csihyeon05/D4D-x-EDTH-Hackathon---Team.-Squad-HUD/pcb/Screenshot From 2026-10-11 06-26-00.png

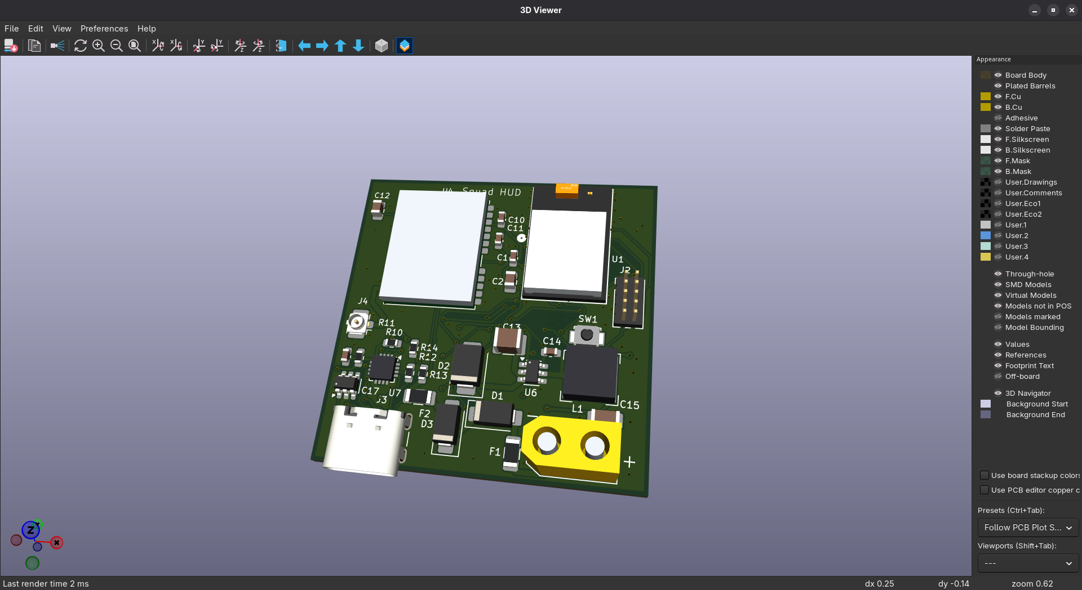
pcb/Screenshot From 2026-10-11 06-26-00.png
