csihyeon05/D4D-x-EDTH-Hackathon---Team.-Squad-HUD/soldier-firmware/README.md

# Soldier Firmware

Node firmware for the NUCODE NU-87 Tiny DK (RTL8720DF) with either an MPU6050 or NU-IMU (LSM6DS3-family), TMP36GT9Z temperature sensor and optional analog Pulse Sensor. Phone GPS reaches the backend over Wi-Fi; UART GPS is disabled by default. Built with the official Realtek AmebaD **3.1.9** Arduino core, board **AMB26**.

The node transmits current BPM, temperature, activity and position every second from startup. Alerts replace the routine packet for that second. Each transmission is an 18-byte packet published through continuous BLE advertisements to `commander-firmware`. Packet, rules and radio format: [docs/DATA_SPEC.md](../docs/DATA_SPEC.md).

## Wiring

Use the MCU signal names printed on the board. Header positions come from NUCODE's NU87-TinyDK schematic, not Arduino D-numbers. All sensors share GND and use 3.3V logic; no input tolerates 5V.

| Signal | NU-87 pin | Arduino index | Header |
|---|---|---|---|
| NU-IMU SDA / MPU6050 SCL | PB21 | 18 | P2 pin 8 |
| NU-IMU SCL / MPU6050 SDA | PB20 | 19 | P2 pin 7 |
| TMP36 VOUT | PB1 / A4 | 11 | P2 pin 5 |
| Pulse Sensor signal | PB2 / A5 | 10 | P2 pin 4 |
| GPS TX → board RX | PB18 / Serial1 RX | 17 | P2 pin 9 |
| GPS RX ← board TX (optional) | PB19 / Serial1 TX | 16 | P2 pin 10 |
| RGB red (onboard) | PA13 | 2 | P1 pin 3; reserved |
| RGB green (onboard) | PA12 | 3 | P1 pin 2; reserved |
| RGB blue (onboard) | PA14 | 1 | P1 pin 4; reserved |

- **TMP36 and Pulse Sensor:** power from 3.3V. TMP36 TO-92 pins: 1 = +VS, 2 = VOUT, 3 = GND (check the datasheet package view). Fit a 100nF bypass capacitor near the TMP36 supply pins.
- **MPU6050:** use a 3.3V-compatible breakout with SDA/SCL pulled up to 3.3V (typically 4.7k, if not already fitted). AD0 = GND gives address 0x68, AD0 = 3.3V gives 0x69; both are probed. INT is not used. Mount the board with its z axis vertical; heading assumes it.
- **Optional UART GPS (`CFG_GPS=1` only):** Serial1, 9600 baud, NMEA GGA/RMC. Match `GPS_BAUD` and supply voltage to the module. UBX-only output is unsupported. GPS RX may be left disconnected; the firmware sends no GPS commands.
- **Do not use:** PA25/PA26 (native USB), PA7/PA8 (onboard CP2102N USB-UART), PA27/PB3 (debug/boot), PA28 (USB reference resistor).

Pins and timing are set in `src/config.h`. Ameba `analogRead` uses factory calibration and returns millivolts scaled by `2^ADC_BITS / 3300`; the TMP36 conversion uses the same denominator. A floating analog input can still read plausible values, so the firmware cannot detect a missing sensor.

## Build, upload, monitor

Requires Arduino CLI on `PATH`, at `~/.local/bin/arduino-cli`, or set in `ARDUINO_CLI`. Every board needs its own `SOLDIER_ID` (1..255); the build fails without one.

```sh
sh tools/nu87.sh setup                                # once: installs Realtek AmebaD 3.1.9
SOLDIER_ID=1 IMU_MODEL=mpu6050 sh tools/nu87.sh build
# Current NU-IMU + TMP36 hardware; no pulse sensor or UART GPS fitted:
SOLDIER_ID=2 IMU_MODEL=lsm6ds3 CFG_PULSE=0 CFG_GPS=0 sh tools/nu87.sh upload /dev/ttyUSB0
sh tools/nu87.sh monitor /dev/ttyUSB0                 # 9600 baud
```

Optional shared map origin, so all soldiers' positions share one frame once GPS has a fix (degrees × 1e7):

```sh
SOLDIER_ID=3 AO_ORIGIN_LAT_E7=520000000 AO_ORIGIN_LON_E7=134000000 sh tools/nu87.sh build
```

The script stages `src/` as a sketch in a temporary private directory and compiles for AMB26 with Auto Upload Mode at 921600 baud. Output image: `.build/output/km0_km4_image2.bin`. Each invocation gets an isolated vendor tool directory to prevent flashing another project's image. Do not run two builds of this same project simultaneously. A successful vendor exit code alone is insufficient; the script requires its explicit transfer-success message.

If upload cannot enter the bootloader: hold BOOT, press and release RESET, release BOOT. Do not erase the whole flash as routine recovery.

Set `CFG_TMP36=0` or `CFG_PULSE=0` when that sensor is absent. A floating ADC input cannot establish sensor presence. `CFG_IMU_DMP=1` enables MPU6050 MotionApps; raw mode is the default. NU-IMU uses raw acceleration/gyro and does not implement MPU6050 DMP.

Phone GPS setup and backend payloads: [frontend handoff](../docs/frontend-handoff/README.md). Phone coordinates are separate from local PDR coordinates; phone fixes do not calibrate the node's heading.

## Operation

At power-on the soldier stands still, facing north, while the node collects a resting baseline. (Until GPS has calibrated the heading, dead reckoning treats the startup direction as north.) Then:

1. **Baseline:** resting heart rate and skin temperature are averaged over 20 valid seconds of each, or whatever was collected after 120 s. This local alert baseline is collected independently of transmission. Every packet contains current measurements, including during baseline collection. The existing commander uses its first valid check-in values as its own baseline; these are not necessarily the local averages.
2. **Every second:** the node evaluates the alert rules (DATA_SPEC section 3) and sends an `ALERT` if one fires; otherwise a `CHECKIN` every second. It does not wait for the baseline or replace current values with averages.
3. **Each packet:** repeated as non-connectable advertisements every 100–120 ms until the next one-second update. The radio stays enabled. `seq` starts at a random value at boot, so a rebooted node is not mistaken for a duplicate.

**Inputs to the rules:**

| Input | Source |
|---|---|
| Heart rate | Pulse Sensor BPM. 0 = no reading; HR rules are skipped. |
| Skin temperature | TMP36. No reading disables the heat rule. |
| Activity | Mean \|(\|accel\| − 1g)\| over 2 s, scaled so 1g = 255. Needs the IMU running; without it, immobility rules are skipped. |
| Impact | Peak \|accel\| per second. An axis at the configured sensor limit counts as an impact, because the true peak cannot be measured. |
| Gas, buttons | Not fitted. Gas is sent as 0; `HAZARD_ENV`, `SITREP_CONTACT` and `SITREP_SOS` are never sent. |

**Position (`x`, `y`):** metres east and north of the origin, sent in decimetres.

- **With a GPS fix:** GPS position.
- **Without:** pedestrian dead reckoning (step detection plus stride length, port of `pdr.py`), continuing from the last GPS position.
- **PDR heading:** optional MPU6050 DMP yaw, or raw gyro integration after 100 consecutive stationary samples. Raw mode assumes the z axis is vertical. Both are relative to startup and drift; neither establishes true north. The optional UART GPS path can learn a heading offset from movement; phone GPS cannot currently do this. Position is unavailable until heading is ready and while the IMU is offline.
- **Origin:** the shared `AO_ORIGIN_*` point if built with one; otherwise the power-on position.

## LED

| Pattern | Meaning |
|---|---|
| Steady cyan | Booting, or DMP loading / waiting for stillness |
| 1 blue pulse every 2 s | Starting live reporting |
| 2 green pulses every 2 s | Reporting (live check-ins active) |
| 3 red pulses every 2 s | Selected IMU offline or TMP36 reading invalid |
| Fast red blinking | Analog task failed or readings stale |

The LED is active-high through SN74LVC3G17 buffers. Faults override the reporting state. No GPS fix and no finger contact are not faults. The main loop drives the LED, so a stalled loop stops the heartbeat; a stall inside the vendor BLE initializer leaves the LED on boot cyan.

## Sensor handling

- **Pulse:** the detector initializes its threshold from the measured DC level and requires at least 8 counts of excursion on its normalized 10-bit scale (about 26 mV) before accepting a beat. This rejects tiny ADC noise; it is not proof of finger contact or measurement accuracy. Weak real signals can also be rejected. Samples at or below 1% or at or above 95% of the ADC scale invalidate BPM immediately. After clipping, one clear second and fresh beats are required to reacquire; this is a conservative signal-quality gate, not a medical accuracy guarantee. It is sampled at 500Hz in its own FreeRTOS task, the only user of the ADC. Sampling gaps invalidate pulse history.
- **TMP36:** 16 readings averaged, spread over time.
- **GPS:** byte budget per loop, checksum and range validation, fix expires after 3 s.
- **IMU:** bounded hardware I2C transfers with software fallback, register verification, data-ready checks and retry after failure. NU-IMU: 52 Hz, ±4g, ±500°/s. MPU6050: ±2g, ±2000°/s, with optional MotionApps 6.12. Sensor scales are selected with the model.
- **ADC:** pulse sampling runs at 500 Hz when enabled; temperature-only sampling runs at 100 Hz.

## DMP startup and recovery

Keep the board still during startup. The firmware resets the MPU6050, uploads the DMP image in 16-byte blocks with read-back verification, then enables it. Startup runs incrementally, so GPS, ADC, radio and the LED keep working. The FIFO is polled over I2C; no INT wire is needed.

IMU data is withheld for at least 10 s after DMP start, and until 100 consecutive packets pass a stillness check (acceleration ≈ 1g, low gyro output, small acceleration changes). This does not prove calibration: slow constant rotation can pass, and there is no absolute heading reference. If the LED stays cyan, keep the board still and check the serial `DMP` line.

FIFO handling: 28-byte packets read as two 14-byte bursts, at most two packets per poll; only the latest valid sample is kept and none is used twice. Overflow, a backlog over four packets, or a partial read resets the FIFO. Three consecutive transfer or decode failures, or 1 s without valid data, takes the IMU offline and restarts initialization. Reinitialization resets the yaw reference, so the PDR heading offset must be relearned from GPS.

Serial `DMP,state=…,fifo_resets=…` states: 0 offline, 1 reset wait, 2 signal reset wait, 3 image upload, 4 start, 5 settling, 6 running. `fifo_resets` includes startup resets. State 6 with changing `QUAT` lines means valid packets, not verified angle accuracy. Yaw drift on this hardware is unmeasured.

Vendored DMP image version, source, checksum and license: [src/sensors/vendor/SOURCE.md](src/sensors/vendor/SOURCE.md).

## Serial output

Onboard USB-UART, **9600 baud, 8N1**. A bounded queue keeps slow UART writes from blocking sampling; lines are dropped when it is full. Vendor boot and BLE stack messages (e.g. `GAP adv start`) also appear.

```text
IMU,t_ms=15000,ax=0,ay=0,az=16384,gx=0,gy=0,gz=0
QUAT,t_ms=15000,w_q30=1073741824,x_q30=0,y_q30=0,z_q30=0
VITALS,t_ms=15000,temp_c_x100=2500,bpm=60,pulse_raw=1800
GPS,t_ms=15000,lat_e7=0,lon_e7=0,alt_cm=0,speed_cms=0,fix=0,sats=0
NODE,t_s=15,activity=2,x_dm=0,y_dm=0,pos=pdr,steps=0,baseline=0,sample_gaps=0
TX_QUEUE,t_s=21,type=2,code=0x00,seq=40213,hr=64,temp_c_x100=3350,x_dm=0,y_dm=0
```

`IMU`, `QUAT`, `VITALS` and `GPS` print once per second (`IMU` only when valid; `QUAT` only with a settled DMP). Each second prints either `NODE` (state, nothing sent) or `TX_QUEUE` (packet queued for sending; `type` 1 = alert, 2 = check-in). `activity=-1` means no valid IMU data.

## Tests

```sh
sh tools/test.sh
```

- **Native C++ (ASan/UBSan):** timing, MPU6050 byte order, I2C failures, TMP36 conversion, pulse timing, NMEA parsing.
- **DMP simulator:** verified image loading, motion gating, partial FIFO packets, overflow and backlog reset, mid-packet bus failure, corruption, stale data, retries, clock wraparound.
- **Node logic:** packet encoding, advertisement layout, activity, heading, PDR, GPS/PDR fusion and heading calibration, baseline, check-in timing, rule handling of missing readings.
- **Parity with `commander-hq/backend`:** the same inputs through the C++ code and the Python reference must give identical packets (500 random) and alert decisions (20 × 1500 s scenarios), and matching PDR tracks.

`comm/advertiser.cpp` also runs against native API fakes covering successful updates, delayed callbacks, rejection, timeout and idle restart. The Arduino build checks the real SDK API. Tests do not establish sensor accuracy, radio range, current draw or wiring. Hardware evidence and remaining checks: [docs/power-validation.md](docs/power-validation.md).

## Not yet done

- NU-IMU acquisition and PC BLE reception passed a bench run; see [integration validation](../docs/sensor-integration-validation.md). Physical commander reception and on-air packet counts still need independent measurement. See the latest continuous-advertising validation record.
- Lowest-power transmission: the Arduino BLE API has no TX power setting.
- Relaying other nodes' packets (`hops` is always 0).
- Report buttons and a gas sensor.
- Calibrate the Weinberg stride constant (`Pdr::WEINBERG_K`) per soldier; tune alert thresholds with measured data.

## Sources

- [NUCODE NU-87 start guide and schematic](https://nucode.gitbook.io/nuseries/downloads/nu-87-tinydk)
- [Realtek AmebaD Arduino core](https://github.com/Ameba-AIoT/ameba-arduino-d): AMB26 variant, calibrated ADC, BLE API, uploader
- [Adafruit MPU6050 driver](https://github.com/adafruit/Adafruit_MPU6050)
- [TMP36 datasheet](https://www.analog.com/media/en/technical-documentation/data-sheets/TMP35_36_37.pdf)

## Optional pulse diagnostics

`CFG_PULSE_TRACE=1` records 1024 raw ADC samples at the configured pulse cadence, starting thirty seconds after boot, then prints `PTRACE` hex blocks at 9600 baud. `PTRACE_TIME` reports the first and last sample times. Acquisition finishes before printing begins. This option is off by default and uses a fixed buffer. Check block indices for missing log lines before analyzing a recording.

Bench capture on 2026-10-11 showed repeated flat upper plateaus around raw 3930 and troughs down to 19. These clipped waveforms cannot substantiate the displayed 200+ BPM. The quality gate prevents reporting them as a usable heart rate; proper skin contact, pressure, light shielding and reference-rate comparison remain necessary.

## Continuous advertising diagnostics

`RADIO` prints once per second. `q` counts queued measurements, `req` counts
accepted update requests and `done` counts successful controller callbacks.
None proves receiver delivery. `gap=2` is ADVERTISING in AmebaD 3.1.9; `wait`
indicates an outstanding update, `cause` the latest SDK result, and `age` the
milliseconds since the last successful completion (4294967295 before any).
`fail`, `timeout` and `start` expose rejected operations, missing responses and
idle restart attempts. A request older than two seconds is flagged; requests
are not overlapped, and late callbacks are handled without counting them twice.

The dedicated non-connectable broadcaster owns the GAP application callback.
Adding GATT connections or scanning requires callback dispatch integration.
`le_adv_set_param(GAP_PARAM_ADV_DATA, ...)` plus `le_adv_update_param()` updates
only data while advertising, as documented in the installed SDK gap_adv.h.
No per-second start/stop or full parameter reset is used. Continuous advertising
increases radio duty cycle; no battery-life claim is made.

`PULSE` reports each one-second raw ADC minimum, maximum, sample count, clipped
sample count and BPM. A narrow range without a periodic waveform cannot support
a reliable BPM; missing readings remain unknown instead of retaining old BPM.

Pulse detection now removes a slow DC baseline and applies two approximately
4 Hz low-pass stages before beat detection. Raw clipping still invalidates BPM;
the filter does not repair clipped or missing optical signals. Tests cover
40/60/90/120/180 BPM, added 50/60/100/120 Hz interference, and a recorded
no-contact trace. Contact accuracy after filtering still requires a physical
reference comparison; a plausible number alone is not validation.

Weak pulse handling uses a minimum filtered swing of four 10-bit counts.
The two 4 Hz low-pass stages preserve weak optical pulses while rejecting
fast interference. Regression tests include a clean 60 BPM pulse narrowing
to a 30 ms width with amplitude falling from 120 to 80 raw ADC counts.
No-contact expiry remains 2.5 seconds; missing BPM is never held indefinitely.
PULSE diagnostics also report filtered peak-to-peak `fpp` and `beat_age` in ms
(4294967295 before a detected beat) to distinguish clipping and missed beats.
