csihyeon05/D4D-x-EDTH-Hackathon---Team.-Squad-HUD/firmware/nucode-project-for-nucode-imu/docs/validation/README.md

# Historical captures

These logs predate migration to the commander advertisement protocol. They preserve sensor and earlier NUS test evidence; they do not describe the current radio format. Current firmware uses 18-byte manufacturer advertisements.
