csihyeon05/D4D-x-EDTH-Hackathon---Team.-Squad-HUD/docs/continuous-radio-validation.md

# Continuous radio and pulse diagnostics validation

## Changes

The soldier remains a non-connectable manufacturer-data broadcaster. It now
updates only GAP_PARAM_ADV_DATA through le_adv_update_param and observes the
asynchronous GAP_MSG_LE_ADV_UPDATE_PARAM response. It no longer stops and starts
advertising for each measurement. Initial advertising has the complete 25-byte
layout, with unavailable sensor values. Advertising uses a 100-120 ms interval;
the latest display measurement is still refreshed every second.

TX_QUEUE means queued, not transmitted. RADIO separately reports GAP state,
queued count, accepted requests, completed callbacks, failures and timeouts.
Controller completion is not proof of RF transmission or receiver delivery.
The application does not overlap update requests. A missing callback is exposed
after two seconds; a late callback is still accepted. It does not reset the MCU
or silently claim recovery from a permanently stuck controller.

## Physical validation

An initial continuous-update experiment with a flags-only startup payload and
20-30 ms interval received 183 successful update callbacks but no sensor packets
in the PC scan. The final radio configuration changes both startup payload and
interval. Their individual contributions were not isolated, and the original
start/stop stall hypothesis has not been proven as the sole root cause.

With the final radio configuration, a 180-second PC scan received 158 distinct
packets, including startup, through node second 181. Median interval between
unique receptions was 1.050 s; maximum was 3.030 s. At node second 184 the serial
log showed gap=2, q=184, req=183, done=183, fail=0, timeout=0, start=1.
IMU read_errors=0 and starts=1. See validation/continuous-radio.csv.
Advertising stayed active beyond the reported initial few successful packets.
This is a local PC radio test, not an independent physical NU40 test, a lossless
transport guarantee or a long-duration endurance test.

## Pulse findings and limits

Before filtering, finger contact produced both plausible 72-85 BPM values and
unstable 230+ BPM values, despite the user reporting steady contact. After the
user removed their finger, the original detector also briefly reported 25-40
BPM from ADC noise. Contact accuracy therefore was not established.

A 1024-sample no-contact recording spanned 2046 ms (500 Hz) and raw values
2032-2065. It is stored as test/fixtures/pulse-no-contact.txt in each soldier
project. Tests replay this measured trace and add synthetic 50/60/100/120 Hz
interference. Two approximately 5 Hz low-pass stages and slow DC removal now
precede beat detection. Tests preserve 40/60/90/120/180 BPM signals, clipping,
stale-sample handling and timestamp wrap. The recorded noise produces no BPM.

PULSE logs full-window raw minimum/maximum, count, clipping and BPM every second.
The optional trace waits 30 seconds after boot and is disabled in the final
normal build. Clipped or absent optical signals remain unavailable. Filtering
cannot establish sensor placement or medical accuracy. Post-filter physical
contact validation remains unverified; the user was told to remove their finger
and no further prolonged contact was required.

Both real target builds and both native suites passed, including protocol parity
against tactical-c2 and the new asynchronous advertiser API tests.

## Final uploaded build, no-contact check

The final build was uploaded with trace disabled. A 60-second scan received
56 distinct packets; every BPM field was unavailable, matching all
63 one-second PULSE windows (BPM 0). Median reception interval was
1.039 s and maximum gap 2.930 s. Final radio counters:

```text
RADIO,gap=2,q=64,req=63,done=63,fail=0,timeout=0,start=1,wait=0,cause=0,age=982
```

The same received bytes are replayed through the tactical-c2 serial reader
for REST/WebSocket handoff; this does not substitute for a physical NU40 test.

## Subsequent 30-second finger-contact check

The user voluntarily reapplied a finger after filtering. A 27-second PC scan
received 25 distinct packets. Startup and node seconds 7-8 included unavailable
HR; received packets from seconds 10-27 contained BPM 52-80, ending at 71.
The serial capture continued for 30 seconds and reached 99 BPM near its end.
At second 29: gap=2, req=28, done=28, fail=0, timeout=0, start=1.
IMU read_errors=0 and starts=1. The user was told to remove their finger at
the end of the 30-second capture.

This verifies physical contact can produce a BPM that reaches the radio and
backend. The rate varied substantially; it does not establish stable or accurate
heart rate, and no simultaneous reference sensor was available.

## Weak-pulse dropout regression

The next reported symptom was alternating numeric BPM and unknown. In the
previous contact log, seconds 7-8 lost BPM despite clip=0, so saturation alone
does not explain all dropouts. A synthetic clean 60 BPM pulse, 30 ms wide and
falling from 120 to 80 ADC counts in amplitude, reproduced loss of detection
with the earlier filtered threshold.

The filtered swing threshold is now four 10-bit counts, paired with two
approximately 4 Hz low-pass stages. Lowering the threshold alone failed the
interference test; the joint change passes weak-pulse continuity, recorded
no-contact noise, 50/60/100/120 Hz interference, and 40-180 BPM regression tests.
Removal still expires BPM; no extra last-value hold was introduced. PULSE logs
now include filtered peak-to-peak range and time since the last detected beat.

Both native suites and both target builds passed. The connected MPU6050 board
was uploaded successfully. Post-tuning physical finger-contact continuity is
not yet verified; the synthetic reproduction is not proof of the exact cause
of every physical dropout.
