csihyeon05/D4D-x-EDTH-Hackathon---Team.-Squad-HUD/tactical-c2/docs/firmware-handoff/continuous-radio/validation/filtered-contact.csv

unix_time | packet_hex | rssi
1791656055.342462 | 1201bca501000000008000008000800000d7 | -64
1791656055.864799 | 1201bda502000000f90807008000800000f3 | -64
1791656056.587958 | 1201bea503000000070907008000800000da | -64
1791656058.553242 | 1201c0a505000037fe0807000000000000b0 | -64
1791656060.314337 | 1201c1a506000037ee08070000000000003b | -64
1791656060.525578 | 1201c2a50700000000090700000000000039 | -64
1791656062.307624 | 1201c3a508000000f50807000000000000fa | -64
1791656063.670443 | 1201c5a50a00004706090700000000000005 | -64
1791656064.908730 | 1201c6a50b000048090907000000000000b6 | -64
1791656066.265582 | 1201c7a50c00004a0009070000000000008e | -64
1791656066.685561 | 1201c8a50d00005009090700000000000018 | -64
1791656067.648919 | 1201c9a50e0000500409070000000000004d | -56
1791656068.500407 | 1201caa50f000048f408070000000000006f | -56
1791656069.958939 | 1201cba5100000440a090700000000000077 | -56
1791656070.484720 | 1201cca511000045fd080700000000000054 | -67
1791656071.539913 | 1201cda51200004508090700000000000075 | -56
1791656072.914852 | 1201cea513000041050907000000000000c5 | -56
1791656073.530171 | 1201cfa514000041fe08070000000000006a | -56
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
