csihyeon05/D4D-x-EDTH-Hackathon---Team.-Squad-HUD/tactical-c2/docs/firmware-handoff/continuous-radio/validation/continuous-radio.csv

unix_time | packet_hex | rssi
1791655516.697238 | 1201000000000000008000008000800000dd | -60
1791655516.804573 | 120135a501000000008000008000800000d0 | -60
1791655517.332170 | 120136a5020000000b0907008000800000de | -60
1791655518.274366 | 120137a50300000010090700800080000030 | -60
1791655520.366845 | 120139a5050000001209070000000000002b | -60
1791655521.202941 | 12013aa50600004d190907000000000000c2 | -60
1791655522.261916 | 12013ba50700004b1c09070000000000000e | -60
1791655523.311525 | 12013ca50800004d0b0907000000000000cf | -60
1791655524.249841 | 12013da50900004a0b0907000000000000f1 | -60
1791655525.288587 | 12013ea50a00004a11090700000000000024 | -60
1791655526.541183 | 12013fa50b00005120090700000000000097 | -60
1791655527.393510 | 120140a50c000051190907000000000000d3 | -60
1791655529.883081 | 120142a50e00004e1a0907000000000000de | -60
1791655530.927210 | 120143a50f00004e170907000000000000a4 | -60
1791655531.553247 | 120144a510000055170907000000000000e3 | -60
1791655532.814001 | 120145a511000054160907000000000000d3 | -60
1791655533.337736 | 120146a5120000501c090700000000000024 | -60
1791655536.367987 | 120149a51500004c180907000000000000ef | -60
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
