csihyeon05/D4D-x-EDTH-Hackathon---Team.-Squad-HUD/docs/validation/pulse-amplitude-vitals.csv

t_ms | temp_c_x100 | bpm | pulse_raw
12113 | 2272 | 0 | 2055
13093 | 2265 | 0 | 2046
14103 | 2270 | 0 | 2056
15097 | 2274 | 0 | 2050
16103 | 2292 | 0 | 1105
17097 | 2257 | 66 | 2147
18093 | 2267 | 63 | 3127
19097 | 2267 | 66 | 2260
20103 | 2273 | 0 | 1053
21097 | 2272 | 0 | 2036
22103 | 2275 | 0 | 1517
23093 | 2264 | 0 | 3676
24097 | 2269 | 0 | 1387
25105 | 2276 | 0 | 2964
26095 | 2274 | 0 | 2072
27093 | 2265 | 0 | 2537
28093 | 2287 | 0 | 2196
29093 | 2266 | 95 | 2181
30097 | 2282 | 95 | 1630
31113 | 2286 | 94 | 1543
32093 | 2273 | 94 | 2114
33093 | 2285 | 84 | 2143
34107 | 2282 | 80 | 2445
35095 | 2275 | 80 | 1841
36093 | 2267 | 80 | 2116
37093 | 2273 | 80 | 1747
38113 | 2283 | 80 | 1548
39097 | 2276 | 0 | 1901
40093 | 2290 | 78 | 1889
41103 | 2279 | 78 | 2731
42103 | 2288 | 81 | 2380
43093 | 2282 | 81 | 1836
44103 | 2276 | 81 | 2399
45103 | 2276 | 81 | 2172
46117 | 2285 | 81 | 2332
47113 | 2262 | 0 | 2202
48103 | 2275 | 79 | 2095
49103 | 2288 | 79 | 2118
50109 | 2277 | 0 | 1930
51107 | 2273 | 92 | 1865
52099 | 2275 | 90 | 2053
53103 | 2289 | 88 | 2077
54107 | 2282 | 82 | 2060
55103 | 2270 | 78 | 2050
56097 | 2269 | 78 | 2108
57093 | 2290 | 82 | 2050
58095 | 2281 | 87 | 2128
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
