csihyeon05/D4D-x-EDTH-Hackathon---Team.-Squad-HUD/docs/validation/pulse-dropout-raw.csv

sample_index | nominal_time_ms | raw_adc
0 | 0 | 2831
1 | 2 | 2835
2 | 4 | 2843
3 | 6 | 2856
4 | 8 | 2867
5 | 10 | 2872
6 | 12 | 2861
7 | 14 | 2867
8 | 16 | 2865
9 | 18 | 2863
10 | 20 | 2858
11 | 22 | 2853
12 | 24 | 2850
13 | 26 | 2852
14 | 28 | 2851
15 | 30 | 2836
16 | 32 | 2840
17 | 34 | 2828
18 | 36 | 2814
19 | 38 | 2794
20 | 40 | 2790
21 | 42 | 2776
22 | 44 | 2766
23 | 46 | 2745
24 | 48 | 2717
25 | 50 | 2703
26 | 52 | 2684
27 | 54 | 2659
28 | 56 | 2633
29 | 58 | 2612
30 | 60 | 2589
31 | 62 | 2559
32 | 64 | 2527
33 | 66 | 2504
34 | 68 | 2474
35 | 70 | 2444
36 | 72 | 2413
37 | 74 | 2380
38 | 76 | 2356
39 | 78 | 2326
40 | 80 | 2296
41 | 82 | 2263
42 | 84 | 2231
43 | 86 | 2189
44 | 88 | 2155
45 | 90 | 2120
46 | 92 | 2075
47 | 94 | 2038
48 | 96 | 2004
49 | 98 | 1967
50 | 100 | 1931
51 | 102 | 1888
52 | 104 | 1852
53 | 106 | 1823
54 | 108 | 1792
55 | 110 | 1751
56 | 112 | 1718
57 | 114 | 1689
58 | 116 | 1663
59 | 118 | 1633
60 | 120 | 1605
61 | 122 | 1577
62 | 124 | 1542
63 | 126 | 1524
64 | 128 | 1501
65 | 130 | 1479
66 | 132 | 1456
67 | 134 | 1436
68 | 136 | 1417
69 | 138 | 1399
70 | 140 | 1384
71 | 142 | 1394
72 | 144 | 1402
73 | 146 | 1410
74 | 148 | 1433
75 | 150 | 1450
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
