csihyeon05/D4D-x-EDTH-Hackathon---Team.-Squad-HUD/(list of files, drawings)

Other design files:
pcb/d4dpcb/d4dpcb-repair.dsn
pcb/d4dpcb/d4dpcb-routing.dsn
