csihyeon05/D4D-x-EDTH-Hackathon---Team.-Squad-HUD/pcb/d4dpcb/d4dpcb.kicad_pcb

## KiCad design pcb/d4dpcb/d4dpcb.kicad_pcb (2026-10-10)

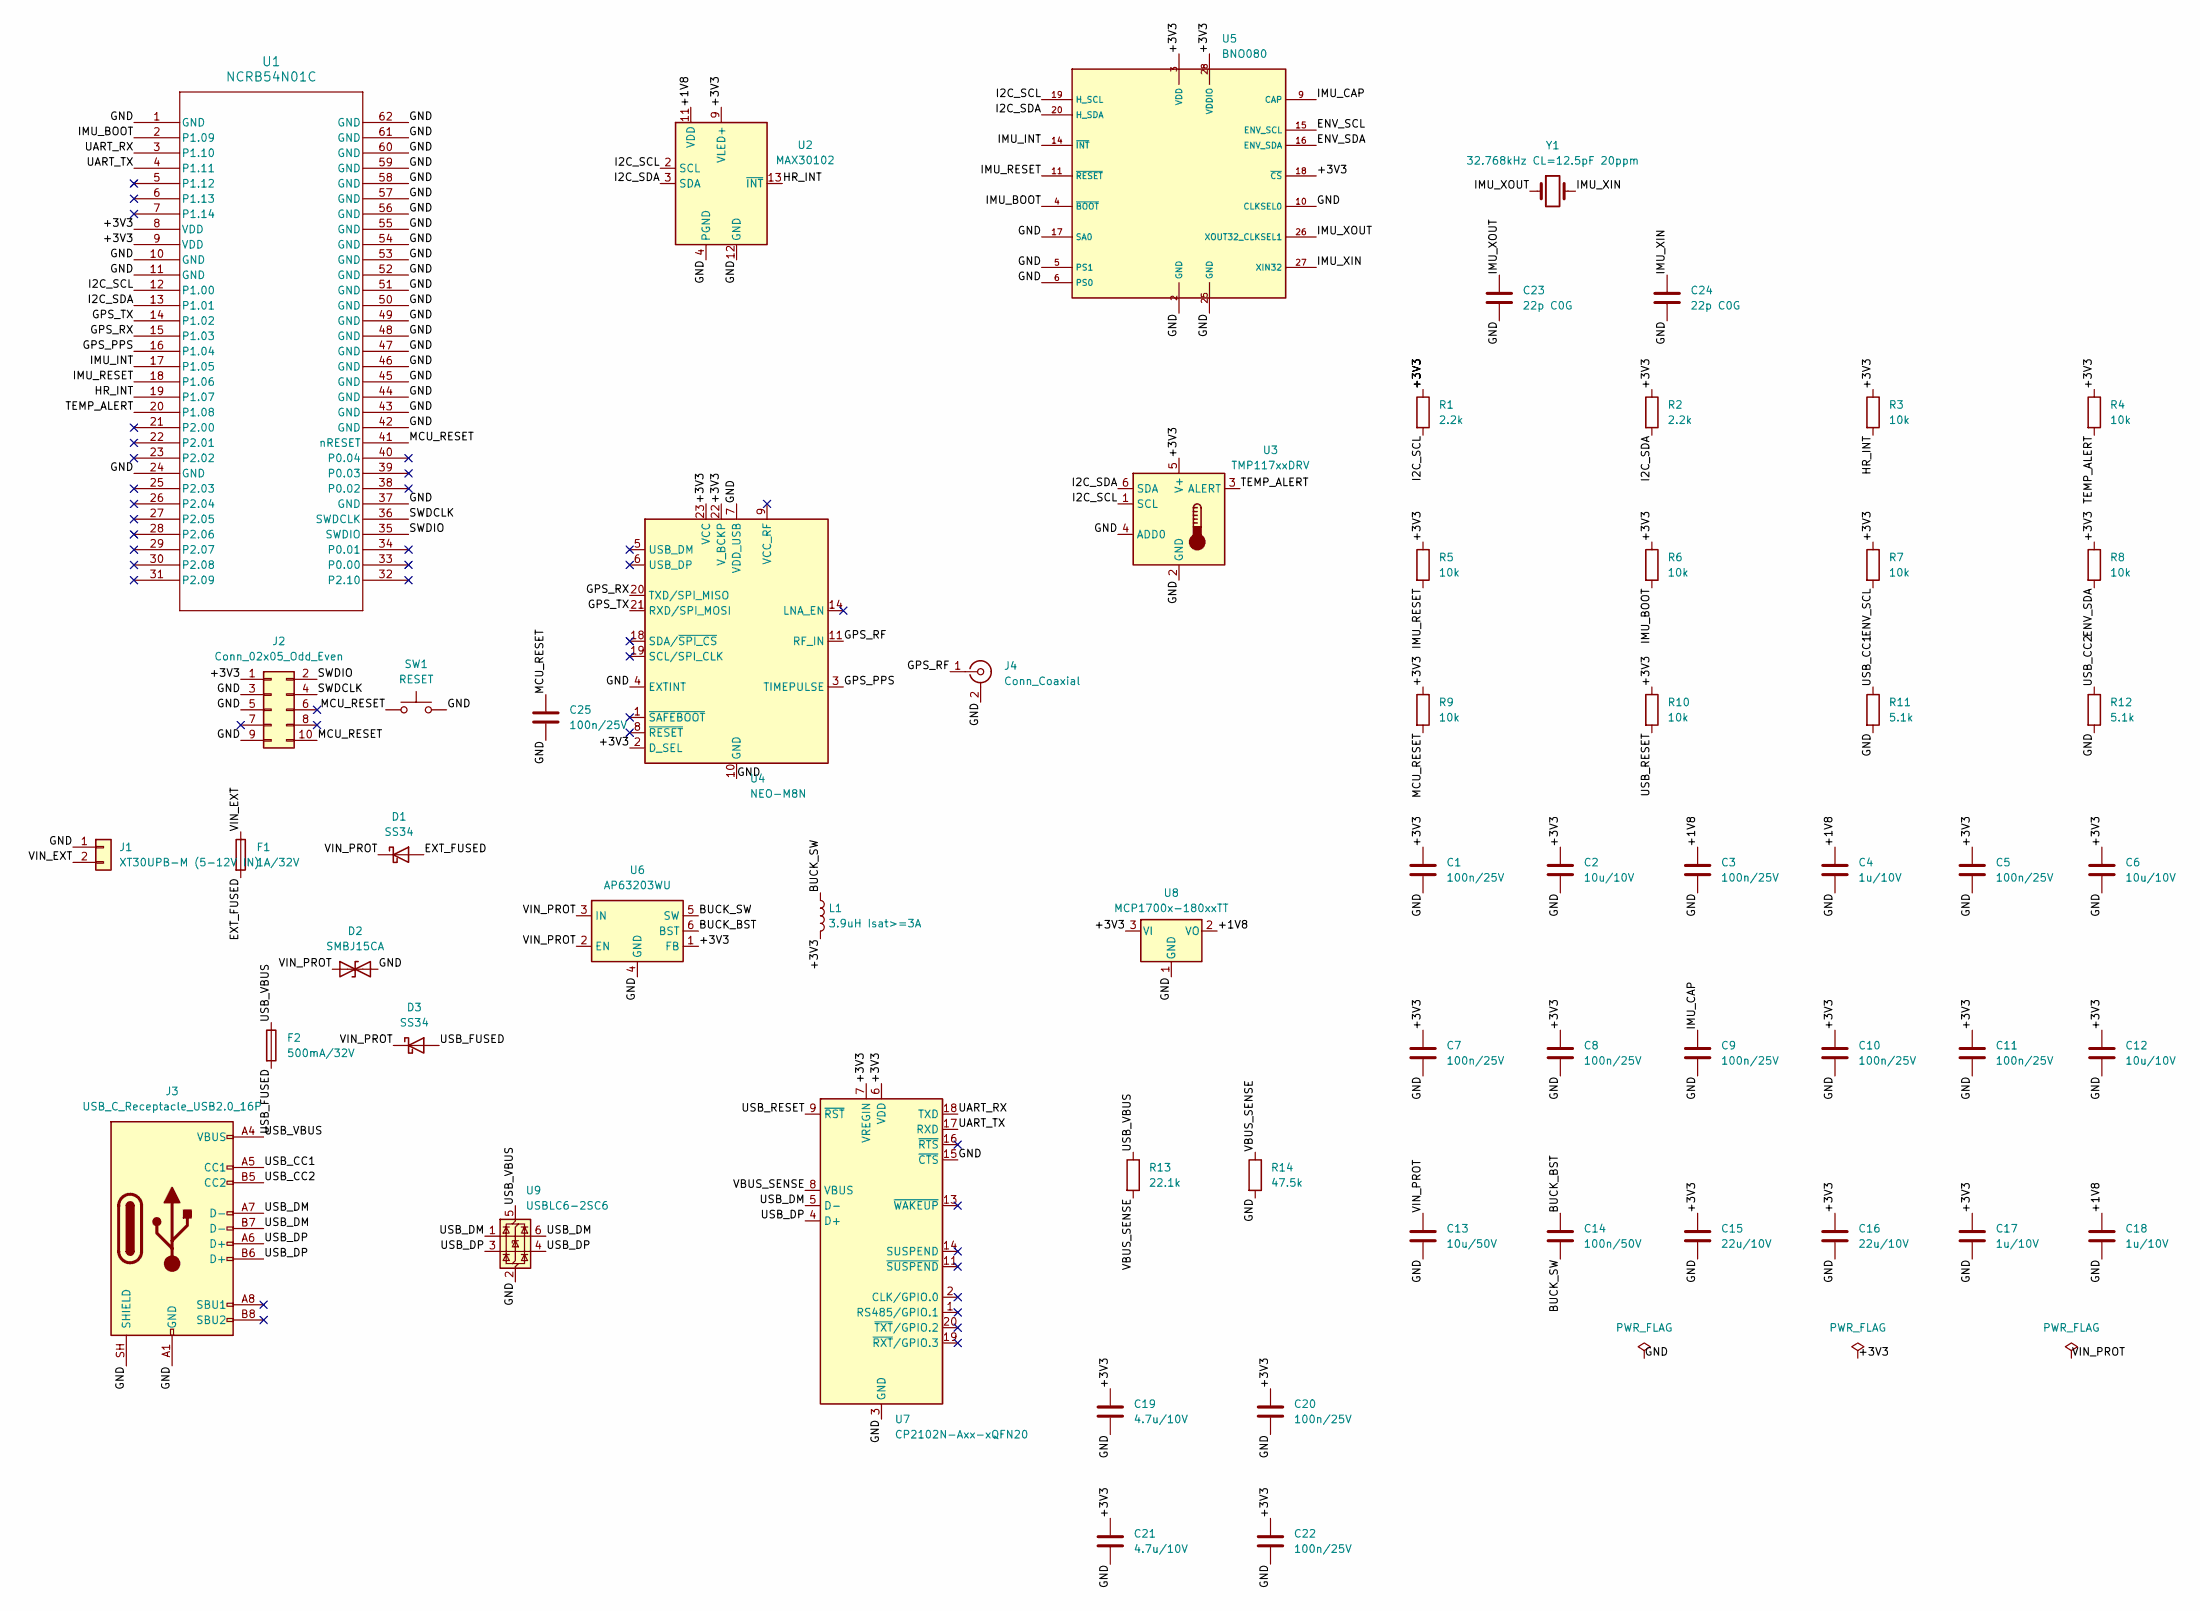
[picture p5: schematic d4dpcb.kicad_sch]

Parts:
C1, C3, C5, C7, C8, C9, C10, C11, C20, C22, C25: 100n/25V; C_0603_1608Metric
C2, C6, C12: 10u/10V; C_0805_2012Metric
C4, C17, C18: 1u/10V; C_0603_1608Metric
C13: 10u/50V; C_1210_3225Metric
C14: 100n/50V; C_0603_1608Metric
C15, C16: 22u/10V; C_1206_3216Metric
C19, C21: 4.7u/10V; C_0603_1608Metric
C23, C24: 22p C0G; C_0603_1608Metric
D1, D3: SS34; D_SMA
D2: SMBJ15CA; D_SMB
F1: 1A/32V; Fuse_1206_3216Metric
F2: 500mA/32V; Fuse_1206_3216Metric
J1: XT30UPB-M (5-12V IN); AMASS_XT30UPB-M_1x02_P5.0mm_Vertical
J2: Conn_02x05_Odd_Even; PinHeader_2x05_P1.27mm_Vertical
J3: USB_C_Receptacle_USB2.0_16P; USB_C_Receptacle_GCT_USB4105-xx-A_16P_TopMnt_Horizontal
J4: Conn_Coaxial; U.FL_Hirose_U.FL-R-SMT-1_Vertical
L1: 3.9uH Isat>=3A; L_Bourns-SRN6028
R1, R2: 2.2k; R_0603_1608Metric
R3, R4, R5, R6, R7, R8, R9, R10: 10k; R_0603_1608Metric
R11, R12: 5.1k; R_0603_1608Metric
R13: 22.1k; R_0603_1608Metric
R14: 47.5k; R_0603_1608Metric
SW1: RESET; SW_SPST_B3U-1000P
U1: NCRB54N01C; MODULE_NU-54_NUC
U2: MAX30102; Maxim_OLGA-14_3.3x5.6mm_P0.8mm
U3: TMP117xxDRV; WSON-6-1EP_2x2mm_P0.65mm_EP1x1.6mm
U4: NEO-M8N; ublox_NEO
U5: BNO080; LGA-28_5.2x3.8mm_P0.5mm
U6: AP63203WU; TSOT-23-6
U7: CP2102N-Axx-xQFN20; SiliconLabs_QFN-20-1EP_3x3mm_P0.5mm_EP1.8x1.8mm
U8: MCP1700x-180xxTT; SOT-23
U9: USBLC6-2SC6; SOT-23-6
Y1: 32.768kHz CL=12.5pF 20ppm; Crystal_SMD_3215-2Pin_3.2x1.5mm

Connections:
/+1V8: C3.1, C4.1, C18.1, U2.11 (VDD), U8.2 (VO)
/+3V3: C1.1, C2.1, C5.1, C6.1, C7.1, C8.1, C10.1, C11.1, C12.1, C15.1, C16.1, C17.1, C19.1, C20.1, C21.1, C22.1, J2.1, L1.2, R1.1, R2.1, R3.1, R4.1, R5.1, R6.1, R7.1, R8.1, R9.1, R10.1, U1.8 (VDD), U1.9 (VDD), U2.9 (VLED+), U2.10 (VLED+), U3.5 (V+), U4.2 (D_SEL), U4.22 (V_BCKP), U4.23 (VCC), U5.3 (VDD), U5.18 (~CS), U5.28 (VDDIO), U6.1 (FB), U7.6 (VDD), U7.7 (VREGIN), U8.3 (VI)
/BUCK_BST: C14.1, U6.6 (BST)
/BUCK_SW: C14.2, L1.1, U6.5 (SW)
/ENV_SCL: R7.2, U5.15 (ENV_SCL)
/ENV_SDA: R8.2, U5.16 (ENV_SDA)
/EXT_FUSED: D1.2 (A), F1.2
/GND: C1.2, C2.2, C3.2, C4.2, C5.2, C6.2, C7.2, C8.2, C9.2, C10.2, C11.2, C12.2, C13.2, C15.2, C16.2, C17.2, C18.2, C19.2, C20.2, C21.2, C22.2, C23.2, C24.2, C25.2, D2.2 (A2), J1.1, J2.3, J2.5, J2.9, J3.A1 (GND), J3.A12 (GND), J3.B1 (GND), J3.B12 (GND), J3.SH (SHIELD), J4.2 (Ext), R11.2, R12.2, R14.2, SW1.2, U1.1 (GND), U1.10 (GND), U1.11 (GND), U1.24 (GND), U1.37 (GND), U1.42 (GND), U1.43 (GND), U1.44 (GND), U1.45 (GND), U1.46 (GND), U1.47 (GND), U1.48 (GND), U1.49 (GND), U1.50 (GND), U1.51 (GND), U1.52 (GND), U1.53 (GND), U1.54 (GND), U1.55 (GND), U1.56 (GND), U1.57 (GND), U1.58 (GND), U1.59 (GND), U1.60 (GND), U1.61 (GND), U1.62 (GND), U2.4 (PGND), U2.12 (GND), U3.2 (GND), U3.4 (ADD0), U4.4 (EXTINT), U4.7 (VDD_USB), U4.10 (GND), U4.12 (GND), U4.13 (GND), U4.24 (GND), U5.2 (GND), U5.5 (PS1), U5.6 (PS0), U5.10 (CLKSEL0), U5.17 (SA0), U5.25 (GND), U6.4 (GND), U7.3 (GND), U7.12 (GND), U7.15 (~CTS), U7.21 (GND), U8.1 (GND), U9.2 (GND)
/GPS_PPS: U1.16 (P1.04), U4.3 (TIMEPULSE)
/GPS_RF: J4.1 (In), U4.11 (RF_IN)
/GPS_RX: U1.15 (P1.03), U4.20 (TXD/SPI_MISO)
/GPS_TX: U1.14 (P1.02), U4.21 (RXD/SPI_MOSI)
/HR_INT: R3.2, U1.19 (P1.07), U2.13 (~INT)
/I2C_SCL: R1.2, U1.12 (P1.00), U2.2 (SCL), U3.1 (SCL), U5.19 (H_SCL)
/I2C_SDA: R2.2, U1.13 (P1.01), U2.3 (SDA), U3.6 (SDA), U5.20 (H_SDA)
/IMU_BOOT: R6.2, U1.2 (P1.09), U5.4 (~BOOT)
/IMU_CAP: C9.1, U5.9 (CAP)
/IMU_INT: U1.17 (P1.05), U5.14 (~INT)
/IMU_RESET: R5.2, U1.18 (P1.06), U5.11 (~RESET)
/IMU_XIN: C24.1, U5.27 (XIN32), Y1.2
/IMU_XOUT: C23.1, U5.26 (XOUT32_CLKSEL1), Y1.1
/MCU_RESET: C25.1, J2.10, R9.2, SW1.1, U1.41 (nRESET)
/SWDCLK: J2.4, U1.36 (SWDCLK)
/SWDIO: J2.2, U1.35 (SWDIO)
/TEMP_ALERT: R4.2, U1.20 (P1.08), U3.3 (ALERT)
/UART_RX: U1.3 (P1.10), U7.18 (TXD)
/UART_TX: U1.4 (P1.11), U7.17 (RXD)
/USB_CC1: J3.A5 (CC1), R11.1
/USB_CC2: J3.B5 (CC2), R12.1
/USB_DM: J3.A7 (D-), J3.B7 (D-), U7.5 (D-), U9.1 (I/O1), U9.6 (I/O1)
/USB_DP: J3.A6 (D+), J3.B6 (D+), U7.4 (D+), U9.3 (I/O2), U9.4 (I/O2)
/USB_FUSED: D3.2 (A), F2.2
/USB_RESET: R10.2, U7.9 (~RST)
/USB_VBUS: F2.1, J3.A4 (VBUS), J3.A9 (VBUS), J3.B4 (VBUS), J3.B9 (VBUS), R13.1, U9.5 (VBUS)
/VBUS_SENSE: R13.2, R14.1, U7.8 (VBUS)
/VIN_EXT: F1.1, J1.2
/VIN_PROT: C13.1, D1.1 (K), D2.1 (A1), D3.1 (K), U6.2 (EN), U6.3 (IN)

Board: 2 copper layers, 60 parts (0 on the bottom side), 37 nets, no tracks yet.
