csihyeon05/D4D-x-EDTH-Hackathon---Team.-Squad-HUD/soldier-firmware/src/sensors/analog_sensors.cpp

#include "analog_sensors.h"
#include <Arduino.h>
#include "config.h"
#include "core/periodic.h"
#include "core/log.h"
#include "core/fractional_ticks.h"
#include "pulse_sensor.h"
#include "tmp36.h"
#include "pulse_trace.h"
#include <FreeRTOS.h>
#include <task.h>
#include <queue.h>

namespace {
struct Reading { VitalsPacket vitals; uint32_t gaps; };
QueueHandle_t readings = nullptr;
void acquire(void*) {
  PulseSensor pulse(PIN_PULSE);
  Tmp36 temperature(PIN_TMP36);
  analogReadResolution(ADC_BITS);
  analogReference(AR_DEFAULT);
  if (CFG_PULSE) pulse.begin();
  if (CFG_TMP36) temperature.begin();
  constexpr uint32_t periodUs = CFG_PULSE ? PULSE_PERIOD_US : 10000;
  static_assert(uint64_t(periodUs) * configTICK_RATE_HZ >= 1000000,
                "Sampling period must be at least one RTOS tick");
  FractionalTicks cadence(periodUs, configTICK_RATE_HZ);
  Periodic temperatureTick(10000);
  TickType_t scheduled = xTaskGetTickCount();
  uint32_t previous = micros(), gaps = 0;
  uint32_t pulseWindowMs = millis(), pulseSamples = 0, clipped = 0;
  uint16_t pulseMin = 4095, pulseMax = 0;
  int filteredMin = INT16_MAX, filteredMax = INT16_MIN;
  for (;;) {
    const TickType_t step = cadence.next();
    vTaskDelayUntil(&scheduled, step);
    // Skip missed deadlines: never fabricate catch-up ADC samples after a stall.
    const TickType_t actual = xTaskGetTickCount();
    if ((TickType_t)(actual - scheduled) >= step) scheduled = actual;
    const uint32_t now = micros();
    if ((uint32_t)(now - previous) > periodUs * 2) ++gaps;
    previous = now;
    if (CFG_PULSE) {
      pulse.sample();
      const uint16_t raw = pulse.raw();
      const uint32_t ms = millis();
      PulseTrace::sample(raw, pulse.bpm(), ms);
      if (raw < pulseMin) pulseMin = raw;
      if (raw > pulseMax) pulseMax = raw;
      if (pulse.filtered() < filteredMin) filteredMin = pulse.filtered();
      if (pulse.filtered() > filteredMax) filteredMax = pulse.filtered();
      ++pulseSamples;
      if (raw <= ADC_SCALE / 100 || raw >= ADC_SCALE * 95 / 100) ++clipped;
      if (uint32_t(ms - pulseWindowMs) >= 1000) {
        LOG("PULSE,min=%u,max=%u,n=%lu,clip=%lu,bpm=%u,fpp=%d,beat_age=%lu\n", pulseMin, pulseMax,
            (unsigned long)pulseSamples, (unsigned long)clipped, pulse.bpm(),
            filteredMax - filteredMin, (unsigned long)pulse.beatAgeMs(ms));
        pulseWindowMs = ms; pulseSamples = clipped = 0;
        pulseMin = 4095; pulseMax = 0;
        filteredMin = INT16_MAX; filteredMax = INT16_MIN;
      }
    }
    if (CFG_TMP36 && temperatureTick.due(micros())) temperature.sample();
    Reading reading{{millis(), temperature.readCelsiusX100(), uint16_t(CFG_PULSE ? pulse.bpm() : 0), uint16_t(CFG_PULSE ? pulse.raw() : 0)}, gaps};
    xQueueOverwrite(readings, &reading);
  }
}
}
bool AnalogSensors::begin() {
  readings = xQueueCreate(1, sizeof(Reading));
  if (!readings) return false;
  if (xTaskCreate(acquire, "analog", 1024, nullptr, 3, nullptr) != pdPASS) {
    vQueueDelete(readings); readings = nullptr; return false;
  }
  return true;
}
bool AnalogSensors::snapshot(VitalsPacket& packet, uint32_t& gaps) {
  Reading reading;
  if (!readings || xQueuePeek(readings, &reading, 0) != pdPASS) return false;
  packet = reading.vitals; gaps = reading.gaps; return true;
}
