csihyeon05/D4D-x-EDTH-Hackathon---Team.-Squad-HUD/(commit log)

2026-10-10 fixed nucode imu problem
    [analog_sensors.cpp, config.h, i2c_api.h, i2c_bus.cpp, i2c_bus.h, i2c_diagnostic.cpp]
2026-10-10 feat(ble): Add NUS sensor telemetry
    Send bounded JSON sensor streams from NU87-1 and NU87-2 using the
    known NUS service. Preserve sensor acquisition and handle subscription,
    fragmentation, local congestion, and disconnect cleanup.
    Record the NU-IMU directory rename and live IMU, TMP36, and BLE checks.
    Both builds and native/Python tests pass. NU87-2 delivered 284 decoded
    messages; MPU hardware and NU40 end-to-end reception remain untested.
2026-10-10 fix(gateway): Expire stale USB backlog
    [main.cpp]
2026-10-10 fix(pulse): Reject noise in both sensor builds
    [pulse_sensor.cpp, pulse_sensor.h, test_firmware.cpp]
2026-10-10 fix(radio): Align soldiers with NU40 gateway
    Replace the legacy NUS sender projects with the validated advertisement
    pipeline used by the commander and tactical-c2. Keep distinct default
    IDs and fitted-sensor profiles for MPU6050 and NU-IMU boards.
    Retain sensor recovery and pulse quality checks. Verify both builds and
    native tests plus packet parity against the tactical-c2 backend.
    [advertiser.cpp, advertiser.h, analog_sensors.cpp, config.h, i2c_api.h, i2c_bus.cpp]
2026-10-10 feat(telemetry): Send live state every second
    Publish current display measurements without waiting for baseline
    collection. Preserve the commander packet format and missing values.
    [main.cpp, schedule.h, test_node.cpp]
2026-10-10 fix(firmware): Stabilize radio and pulse data
    Keep advertisements active and observe update completion separately
    from queueing. Use a full startup payload and a conservative interval.
    Suppress ADC noise before beat detection and expose signal diagnostics.
    Cover callback failures, recorded noise and synthetic pulse signals.
    [continuous-radio.csv]
2026-10-10 docs(pulse): Record finger contact validation
    [filtered-contact.csv]
2026-10-10 fix(pulse): Preserve weak beat detection
    Avoid losing clean weak pulses after filtering without accepting
    fast interference. Keep missing-signal expiry and expose beat age.
    Add a regression that fails with the previous detector settings.
    [analog_sensors.cpp, pulse_filter.h, pulse_sensor.cpp, pulse_sensor.h, test_firmware.cpp]
2026-10-10 fix(pulse): Recover from missed beats
    [pulse_sensor.cpp, pulse_sensor.h, test_firmware.cpp]
2026-10-10 fix(pulse): Adapt to changing signal amplitude
    [analog_sensors.cpp, pulse_sensor.cpp, pulse_sensor.h, pulse_trace.cpp, test_firmware.cpp]
2026-10-10 docs(pulse): Record dropout interference
    [pulse-amplitude-vitals.csv, pulse-dropout-raw.csv]
2026-10-10 Replace branch contents with the integrated project (integration bc8ef0b)
    All previous files on this branch removed; tree now equals integration@bc8ef0b
    (firmware + soldier-firmware + tactical-c2 backend/COP + example run).
    Claude-Session: https://claude.ai/code/session_019UQPghcU2rzZuZfaMPjnPm
    [continuous-radio.csv, filtered-contact.csv, pulse-amplitude-vitals.csv, pulse-dropout-raw.csv]
2026-10-10 feat: add pcb
    [d4dpcb-before-routing.kicad_pcb, d4dpcb-repair.dsn, d4dpcb-routing.dsn, d4dpcb-routing.kicad_pcb, d4dpcb-routing.kicad_sch, d4dpcb.kicad_pcb, d4dpcb.kicad_sch]
