csihyeon05/D4D-x-EDTH-Hackathon---Team.-Squad-HUD/(notices)

Notices in the files:
README.md:
License: Apache 2.0
